Guilherme-Filardi/controle-potencia-aerodesign/hardware/hardware_zebra_rev05.html

# Hardware do controlador de potência

Zebra Aerodesign · placa perfurada 40 × 60 mm, montagem manual · conjunto revisão 05

Antes de soldar: conte os furos da sua placa, este mapa usa 15 colunas por 23 linhas. Depois encaixe o módulo a seco nas barras fêmea, com o chip para cima e o USB na borda da linha 1, e confira duas coisas: o pino 1 cai na linha 4, e o pino VIN fica na coluna M, do lado direito. Se o VIN cair na coluna C, pare: o módulo está virado.

## 1. O que esta placa é

Um carrier para o ESP32 DevKit V1, construído à mão em placa perfurada dupla face de 40 × 60 mm, com montagem ponto a ponto e componentes de furo passante. Essa é a placa de voo.

- O barramento S.Port atravessa a placa: entra por J1 e sai por J4. Não há emenda em Y no chicote.
- Os chicotes são de fio soldado direto na placa, com conector modul na outra ponta.
- Alimentação vem do chicote do S.Port do receptor, não do SBUS.
- Sem conector de expansão: o projeto encerra aqui, e furo não usado é complicação sem retorno.
- Sem restrição de antena: o rádio do ESP32 não é usado.
- Amarração do chicote pela própria grade de furos, na borda de saída.

Por que a construção manual é adequada aqui. Esta placa não conduz corrente de motor: apenas sinal, na casa dos miliampères, e a alimentação de 5 V do BEC. Não há questão térmica nem de seção de condutor. O risco desta placa é mecânico, e está tratado na seção 9.5.

## 2. Esquema elétrico

Esquema elétrico, revisão 05.

## 3. Chicotes

Ref. | Borda | Vai para | Fios | Sinal na placa
J1 | entrada | S.Port do receptor | 3 | SIG → nó S.Port · +5V → rail · GND
J2 | entrada | SBUS do receptor | 2 | SIG → R1 → D16 · GND
J3 | saída | MASTER do ESC | 2 | SIG ← R3 ← D18 · GND
J4 | saída | S.Port do ESC | 2 | SIG → nó S.Port · GND

Total: 9 furos de sinal.

O nó S.Port é o ponto crítico do roteamento. A trilha entre J1 e J4 é o barramento que liga o receptor ao ESC e deve ser curta, larga e sem nenhum componente em série. O resistor R2 fica apenas no ramo que sobe até o D4. Resistor no caminho principal degrada os tempos de subida de um barramento que já é dreno aberto com pull-up, e quebra o polling entre receptor e ESC. O sintoma seria telemetria morta com motor funcionando normalmente, que é difícil de diagnosticar.

J1 é a exceção. Três dos quatro chicotes têm a via de 5 V cortada. Se o chicote de J1 for montado por hábito, com o positivo também cortado, a placa não liga. A marcação ÚNICO COM 5 V ao lado de J1 é obrigatória, e a forma dela está na seção 9.4.

Todos saem pela borda esquerda, coluna A, do lado dos pinos de sinal do módulo. Uma abraçadeira só, ao longo dessa borda, segura o feixe inteiro. O fio de terra de cada chicote entra perto do sinal dele, mas não sempre no furo vizinho: o mapa agrupa os terras para que eles se liguem por ponte de solda.

Ref. | Furos | Vai para
J1 | A4 = +5 V · A5 = GND · A7 = sinal | S.Port do receptor. Único com 5 V.
J4 | A6 = GND · A8 = sinal | S.Port do ESC.
J2 | A10 = sinal · A14 = GND | SBUS do receptor.
J3 | A13 = sinal · A15 = GND | MASTER do ESC.

## 4. Consequência da topologia de passagem

Com o S.Port atravessando a placa, ela deixa de ser opcional para o enlace de telemetria. Trilha rachada ou solda fria nessa rede derruba a leitura no rádio. Do lado do controle isso é tolerável, porque o firmware degrada para ação antecipatória isolada, que é o comportamento seguro previsto em projeto. Do lado do piloto, a telemetria simplesmente some. A troca foi consciente: menos emenda no chicote, mais dependência da placa.

Um efeito favorável: trocar J1 por J4 na montagem é inofensivo, porque são o mesmo nó elétrico. E plugar o chicote errado não energiza a placa, já que o positivo só existe em J1.

## 5. Lista de materiais

Ref. | Componente | Valor | Encaps. | Qtd. | Função
· | Placa perfurada | dupla face, 40 × 60 mm, passo 2,54 mm | · | 1 | placa de voo
U1 | Módulo | ESP32 DevKit V1, 30 pinos, USB-C | · | 1 | soquetado
· | Barra fêmea | 1×15, passo 2,54 mm | THT | 2 | fileiras a 25,4 mm
R1, R2 | Resistor | 330 Ω | axial 1/4 W | 2 | limitação de falta nas entradas
R3 | Resistor | 100 Ω | axial 1/4 W | 1 | série na saída PWM
R4, R5 | Resistor | 1 kΩ | axial 1/4 W | 2 | LEDs
C1 | Capacitor | 47 µF 16 V | eletrolítico | 1 | reserva no rail de 5 V
C2 | Capacitor | 100 nF | cerâmico | 1 | desacoplamento, junto ao VIN
D1 | LED verde | 3 mm | THT | 1 | estado armado
D2 | LED âmbar | 3 mm | THT | 1 | telemetria válida
D3 | Schottky | 1N5818 | DO-41 | 1 | proteção contra inversão do J1
· | Fio fino com capa | rígido, de jumper | · | 7 pedaços | fios da face de baixo (seção 8)

Na montagem: a faixa pintada é o cátodo, e vai no +5 V. O D3 fica reverso entre o rail de 5 V e o terra, então em operação normal ele bloqueia e não faz nada. Montado ao contrário, vira curto permanente no instante em que a placa é energizada.

O que o D3 cobre, e o que não cobre. Ele existe para o caso de o chicote do J1 ser ligado invertido: aí o Schottky conduz e prende a linha em cerca de −0,5 V, em vez de deixar −5 V chegar ao ESP32. Ele não protege contra sobretensão, e isso é consequência aceita, por três motivos:

- O regulador AMS1117 do DevKit aceita 15 V de entrada, máximo absoluto de datasheet. Com 5 V na linha há 3x de folga, e nenhuma variação normal de BEC chega perto.
- O C1 de 47 µF já absorve transiente rápido antes que ele vire tensão no regulador.
- Sobretensão real só viria de falha dura do BEC, que colocaria a tensão do pacote 6S, cerca de 25,2 V, na linha. Só que o mesmo BEC alimenta o receptor: nesse cenário a aeronave já está perdida, e salvar o ESP32 não muda o desfecho.

O D3 é sacrifical, não é a solução. O 1N5818 aguenta 1 A e o BEC entrega vários amperes: numa inversão ele conduz muito acima do que suporta e morre, normalmente em curto, que é o modo bom, porque continua segurando a linha. A proteção de verdade contra inverter o J1 é o conector chaveado da seção 9.4, que impede o erro em vez de remediá-lo. O certo é ter os dois.

## 6. Mapa de furos

Como ler. Coluna A a O nos 40 mm, linha 1 a 23 nos 60 mm. A linha 1 é a borda do USB. Os dois desenhos mostram a mesma placa. O primeiro é a face de cima, com as peças. O segundo é a face de baixo, do jeito que a placa fica na sua mão na hora de soldar os fios: virada de lado, com o USB ainda em cima. Por isso, no segundo desenho, a coluna A fica à direita.

Cores: vermelho é 5 V, preto é terra e azul é sinal. Barra grossa e curta é ponte de solda entre dois furos vizinhos. Linha com número é fio com capa.

Face de cima: peças, módulo e saída dos chicotes.

Face de baixo: 23 pontes de solda e 7 fios.

Para não se perder ao virar a placa: antes de começar, marque com caneta o canto da coluna A com a linha 1, nas duas faces.

## 7. Ordem de montagem e onde vai cada peça

1. Barras fêmea nas colunas C e M, linhas 4 a 18. Solde com o módulo encaixado, para as fileiras ficarem paralelas, e tire o módulo depois.
2. Peças da face de cima, das mais baixas para as mais altas: resistores, D3, C2 e LEDs. O C1 fica por último, deitado e colado.
3. Pontes de solda na face de baixo (seção 8).
4. Fios com capa na face de baixo (seção 8).
5. Chicotes na coluna A, entrando por cima e soldados embaixo (seção 3).
6. Conferência com o multímetro (seção 10), antes de encaixar o módulo de novo.

Ref. | Peça | Furos | Atenção
R2 | 330 Ω | B7 e B8 | em pé
R1 | 330 Ω | A9 e B9 | em pé
R3 | 100 Ω | B12 e A12 | em pé
R5 | 1 kΩ | D22 e E22 | em pé
R4 | 1 kΩ | L22 e K22 | em pé
D3 | 1N5818 | B3 e B5 | em pé, faixa em B3 (para cima)
C2 | 100 nF cerâmico | N4 e N5 | rente à placa
D2 | LED âmbar 3 mm | F22 e F23 | perna longa em F22
D1 | LED verde 3 mm | J22 e J23 | perna longa em J22
C1 | 47 µF eletrolítico | O6 e N6 | + em O6, deitado para baixo sobre N7 a O10, colado

Os cinco resistores vão em pé: o corpo em cima de um furo e a outra perna dobrada até o furo vizinho. O R2 fica na vertical, na coluna B. R1 e R3 ficam na horizontal, entre as colunas A e B. R4 e R5 ficam na linha 22. Nenhuma perna entra em furo das barras fêmea: a ligação com o pino do módulo é sempre uma ponte de solda embaixo.

## 8. Pontes de solda e fios

Ponte de solda é uma gota de solda unindo dois furos vizinhos. Se a gota não pegar, use uma sobra de perna de resistor como barrinha. São 23 pontes:

Rede | Pontes | Para que servem
5 V (4) | A3-A4 A3-B3 M3-M4 M4-N4 | J1 ao D3 · VIN ao C2
terra (10) | A5-B5 B5-C5 A5-A6 A14-A15 M5-N5 N5-N6 F23-G23 G23-H23 H23-I23 I23-J23 | J1 e J4 ao D3 e ao GND do módulo · J2 com J3 · C2 e C1 ao GND · barra dos LEDs
sinal (9) | A7-A8 A7-B7 B8-C8 A9-A10 B9-C9 B12-C12 A12-A13 E22-F22 K22-J22 | S.Port J1 com J4 e o R2 · R2 ao D4 · R1 ao J2 e ao D16 · R3 ao D18 e ao J3 · resistores aos LEDs

Os 7 fios têm de ter capa. Solde só nas pontas. No meio do caminho eles passam perto de outras soldas, e a capa é o que evita curto. Deixe cada fio rente à placa e prenda com uma gota de cola.

Fio | Caminho (face de baixo) | Cortar com | O que é
1 | B3 → M3 | 38 mm | 5 V do J1 até o VIN do módulo. Segue a linha 3, que é livre.
2 | C5 → M5 | 35 mm | Terra de uma fileira do módulo à outra. Segue a linha 5, entre as barras.
3 | O6 → O4 → N4 | 18 mm | 5 V até o + do C1.
4 | N6 → N21 → M21 → M23 → J23 | 63 mm | Terra do lado do VIN até o LED verde. Desce pela coluna N e segue pela linha 23.
5 | A15 → A21 → C21 → C23 → F23 | 43 mm | Terra do J2 e do J3 até o LED âmbar. Desce pela coluna A e segue pela linha 23.
6 | C14 → D14 → D22 | 33 mm | D21 até o R5 do LED âmbar. Desce pela coluna D.
7 | C13 → E13 → E20 → L20 → L22 | 56 mm | D19 até o R4 do LED verde. Desce pela coluna E e atravessa na linha 20.

A medida para cortar já inclui 5 mm em cada ponta, para descascar e dobrar.

## 9. Geometria, marcação e pontos de falha

### 9.1 Geometria e ocupação

- Soquete: duas fileiras de 15 furos, passo 2,54 mm, fileiras a 25,4 mm entre centros. Confirmado por medição.
- Placa: perfurada dupla face de 40 × 60 mm, passo 2,54 mm. A grade tem cerca de 15 × 23 furos.
- Ocupação: as barras fêmea ficam nas colunas C e M, linhas 4 a 18. O corpo do módulo cobre das colunas C a M e das linhas 1 a 21. Na face de cima nada fica embaixo dele: as peças ficam nas colunas A, B, N e O e nas linhas 22 e 23.
- USB-C voltado para a borda, para regravar o firmware sem desmontar nada.
- Terra por pontes de solda e fios, não por plano. Sem restrição de antena: o rádio do ESP32 não é usado.

### 9.2 Chicotes e amarração

- O fio entra pelo furo e é soldado dos dois lados. O esforço vai para o corpo da placa, e não para a colagem do cobre da ilha.
- Abraçadeira pela própria grade, 5 mm atrás de cada solda de chicote, alinhada com o sentido em que o fio corre, para não dobrar o cabo duas vezes.
- Gota de cola quente ou epóxi sobre cada junta de chicote, depois da abraçadeira.
- Deixar folga de serviço no fio: o chicote nunca deve trabalhar esticado.

### 9.3 Posicionamento

- Placa deitada, módulo para cima, montada no meio da aeronave e vista de cima.
- LEDs na face superior, nas linhas 22 e 23: fora do corpo do módulo, na borda oposta ao USB e longe do chicote.
- C2 a 2,5 mm do pino VIN, ligado a ele por ponte de solda.
- C1 deitado e colado. É a peça mais alta e mais pesada da placa; em pé, ela balança com a vibração e trinca as soldas das pernas.
- Quatro furos de 3,2 mm nos cantos, para M3 com coxim de borracha. A placa é de fenolite, que racha em vez de flexionar: o coxim não é conforto, é requisito.

### 9.4 Marcação

Não há serigrafia. A marcação é física e precisa existir antes da primeira energização:

- ÚNICO COM 5 V junto a J1. Etiqueta colada, termorretrátil de cor distinta no chicote ou conector com chaveamento diferente dos demais. O conector chaveado é o mais seguro, porque impede o erro em vez de avisar sobre ele.
- Nome e sentido de cada chicote, por extenso.
- Ordem dos fios marcada em cada grupo, e o pino 1 identificado.

### 9.5 Pontos de falha mecânica

Numa aeronave que vibra, a falha não vem do condutor. Vem destes três lugares, em ordem de risco:

Onde | O que acontece | Mitigação
Solda de chicote na borda | O fio flexiona, encrua na solda e arranca a ilha | Abraçadeira e cola, seção 9.2
DevKit no soquete | A vibração faz o módulo caminhar para fora | Manter o soquete, porque é preciso trocar o módulo na sintonia, e prender com abraçadeira nas duas pontas antes do voo
Fios da face de baixo | Fio longo e solto ressoa e racha a solda nas pontas | Rente à placa e colado

## 10. Conferir antes de energizar

Comece com o módulo fora do soquete e o multímetro em continuidade (o bip). Nos itens de resistência, use a escala de ohms.

1. 5 V contra terra: ponta vermelha em A4 e preta em A5. Não pode apitar. Um bip curtinho no começo é o C1 carregando; bip contínuo é curto.
2. D3 no sentido certo: multímetro no teste de diodo. Vermelha em A4 (5 V) e preta em A5 (terra): tem de dar aberto. Com as pontas trocadas, tem de marcar cerca de 0,2 a 0,4 V depois que o número parar. Se der o contrário, o D3 está invertido e vira curto ao ligar.
3. S.Port direto: A7 e A8 apitam. Se der 330 Ω, o R2 foi parar no caminho principal, e a telemetria morre com o motor rodando normal.
4. Resistores no lugar: 330 Ω entre A7 e C8 · 330 Ω entre A10 e C9 · 100 Ω entre C12 e A13 · 1 kΩ entre C13 e J22 · 1 kΩ entre C14 e F22. Nos furos da coluna C, encoste a ponta no contato da barra fêmea.
5. Terra ligado: A5 apita com A6, A14, A15, C5, M5, N6, F23 e J23.
6. 5 V ligado: A4 apita com B3, M4, N4 e O6.
7. Vizinhos que não podem apitar: A13 com A14 (PWM com terra) · A6 com A7 · A8 com A9 · B8 com B9 · B7 com C7 · C4 (3V3) com A4 e com A5.
8. Posição do módulo, agora com ele encaixado e ainda sem energia: o pino escrito VIN no módulo apita com A4, e o pino 3V3 não apita com A4. É esse teste que pega o módulo virado.
9. Energize só pelo receptor, sem bateria de propulsão, e confira 3,3 V entre os pinos 3V3 e GND do módulo antes de ligar o ESC.

## 11. Rádio desligado no firmware

O rádio do ESP32 opera em 2,4 GHz, a mesma faixa do receptor, que fica a centímetros dele. Se ligar em voo, pode ensurdecer o receptor e derrubar o enlace de comando. As duas versões do firmware, zebra_fc_rev01 e zebra_fc_pcb_rev00, já desligam WiFi e Bluetooth explicitamente no setup(), com as três chamadas abaixo. Não tirar isso numa alteração futura.

#include "esp_wifi.h"
#include "esp_bt.h"

// Radio desligado de proposito: 2,4 GHz a centimetros do receptor.
esp_wifi_stop();
esp_wifi_deinit();
esp_bt_controller_disable();

## 12. Evolução prevista

O mesmo esquema elétrico da seção 2 serve para fabricação em PCB, em serviço tipo PCBWay, sem alteração de projeto: muda o processo de montagem, não o circuito. Fica como trabalho futuro, depois que a bancada e o voo validarem a lei de controle.

## 13. Falta decidir

A marcação do J1. Não há serigrafia, e ele é o único chicote com 5 V. Conector com chaveamento diferente dos outros três impede o erro em vez de avisar.
