Guilherme-Filardi/controle-potencia-aerodesign/(commit log)

2026-09-15 Publica o controle de potência para AeroDesign
    Firmware de bancada e da placa, biblioteca SBUS modificada, documentação da placa, dados brutos dos ensaios, figuras e página de apresentação.
    [10em10_baixo.csv, 10em10_full.csv, 10em10_midle.csv, Progressão_FULLBAT.xlsx, Progressão_HALFBAT.xlsx, SimulaçãoDecolagem_FULLBAT_CONDIÇÃO_REAL_VOO.xlsx, full_full.csv]
2026-09-15 Detalha a origem dos dados de ensaio
    Os CSV são os originais do ESC e as planilhas são recortes deles.
2026-09-15 Corrige a exibição das fórmulas
    Blocos de fórmula no formato math, para preservar os espaçamentos.
